Memphis003/OpenTrickler/CommunityContributions/Memphis/V1/readme.md

# A&D FX Shield by Memphis

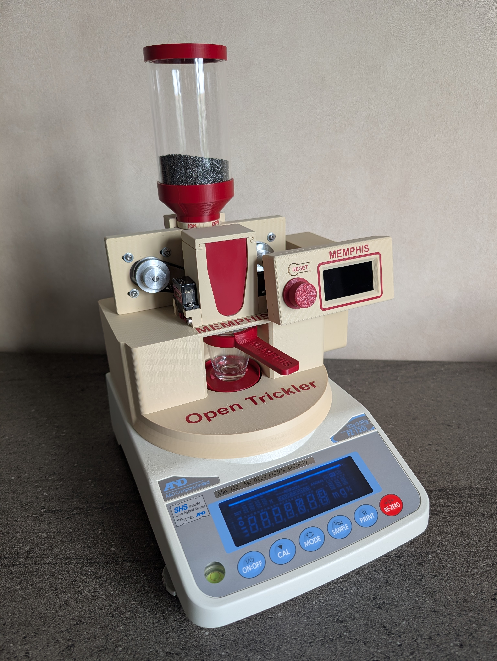
[picture p10: CommunityContributions/Memphis/V1/resources/Overview_1.jpg]

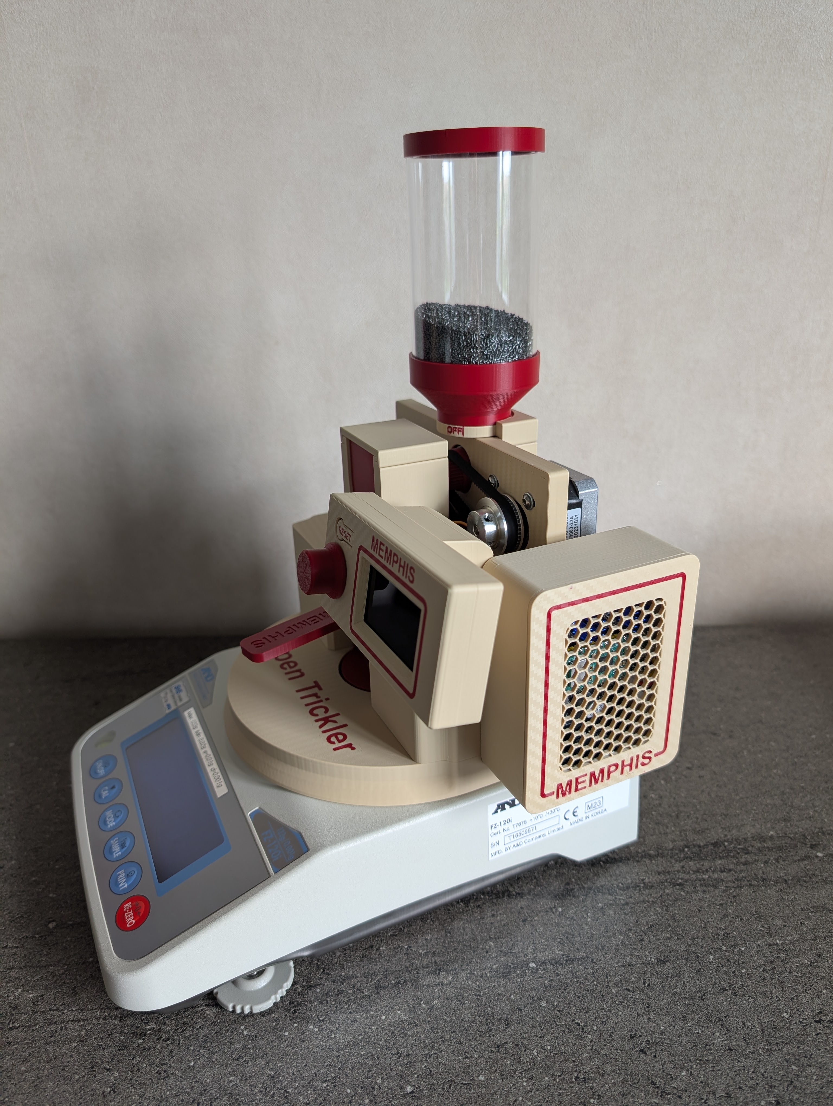
[picture p11: CommunityContributions/Memphis/V1/resources/Overview_2.jpg]

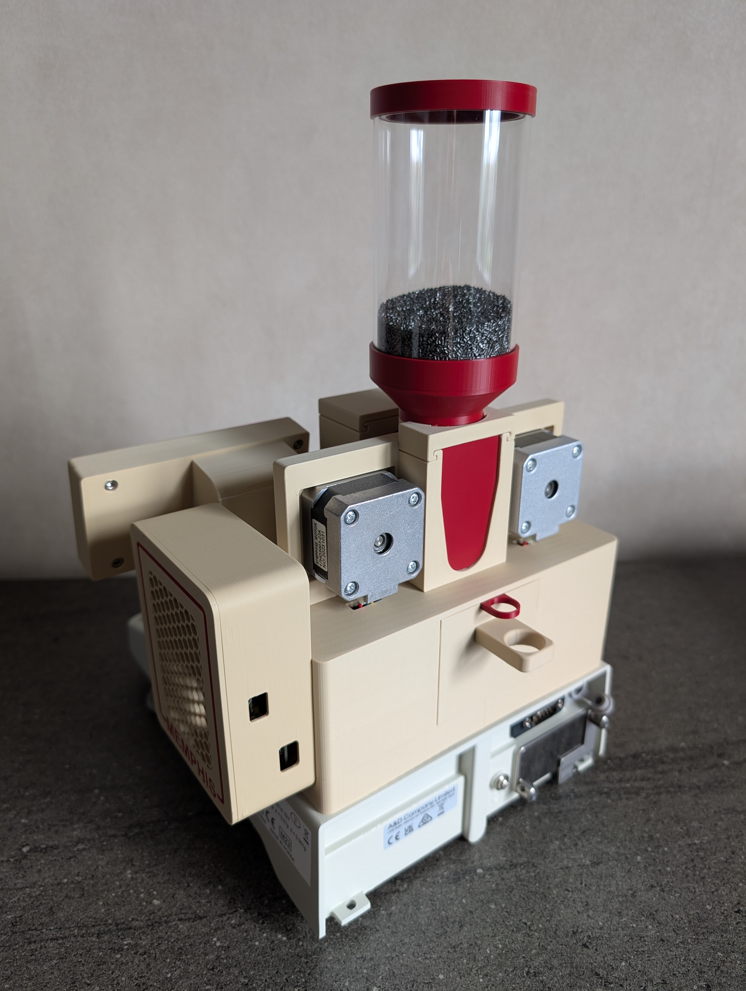
[picture p12: CommunityContributions/Memphis/V1/resources/Overview_3.jpg]

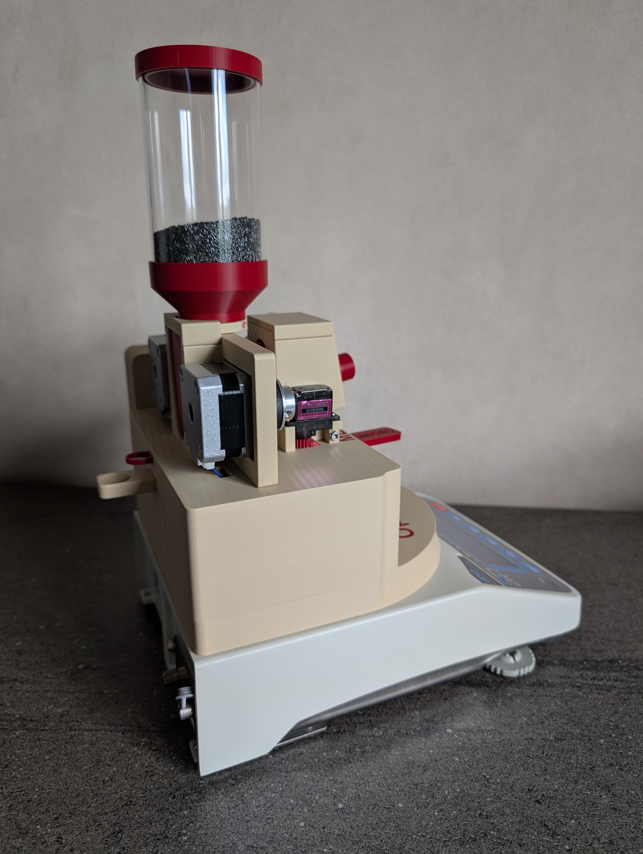
[picture p13: CommunityContributions/Memphis/V1/resources/Overview_4.jpg]
  

## BOM

- Heatset Inserts M3x5x4: 24
- Nut M3: 4
- M3x6 BHCS: 4
- M3x10 BHCS: 16
- M3x10 SHCS: 4 
- M3x12 SHCS: 4  

- A shot glass, height: 50mm, diameter at top: 41.6mm
- An o-ring 35mm in diameter  

- WS2812B led with cable and connector
- 13mm lens

## Assembly guide

### Rear discharge mount
Use 4x M3x12 SHCS with [rear_discharge_mount.stl](STL/rear_discharge_mount.stl) to join the [rear_body_without_holes.stl](STL/rear_body_without_holes.stl) to the [scale_shield.stl](STL/scale_shield.stl).
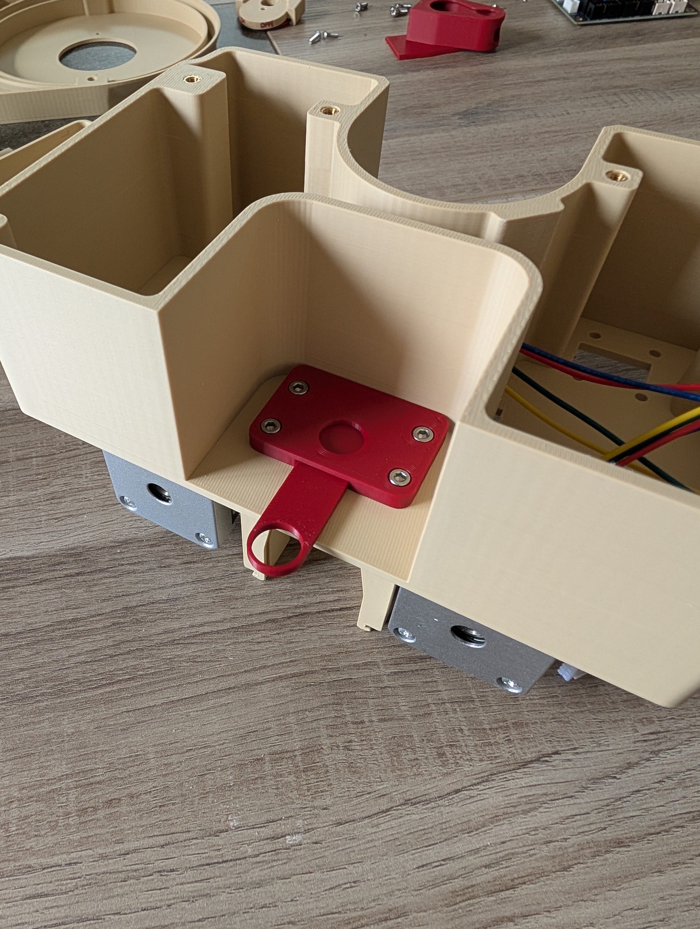
[picture p14: CommunityContributions/Memphis/V1/resources/Rear_discharge_mount.jpg]
  

### LED
Use one of the connectors provided with the 3D mellow PCB.  
Be sure to use the LED's DI pin.  
You need a 13mm diameter lens.  
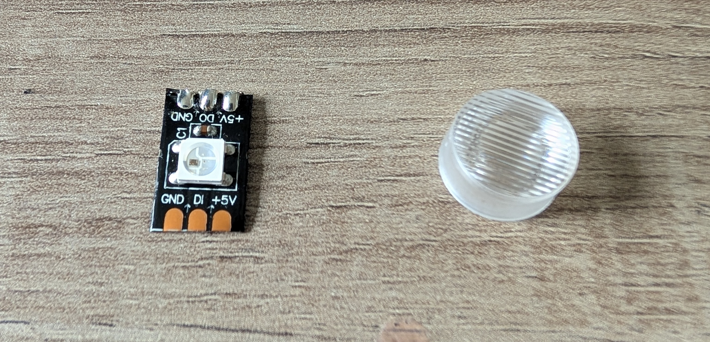
[picture p15: CommunityContributions/Memphis/V1/resources/Led_1.jpg]

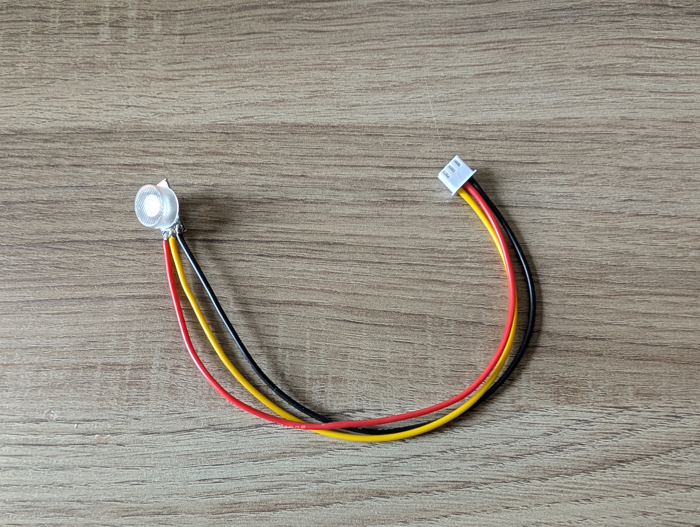
[picture p16: CommunityContributions/Memphis/V1/resources/Led_2.jpg]
  

Place the lens in the hole after adjusting it if necessary with a file and sandpaper.
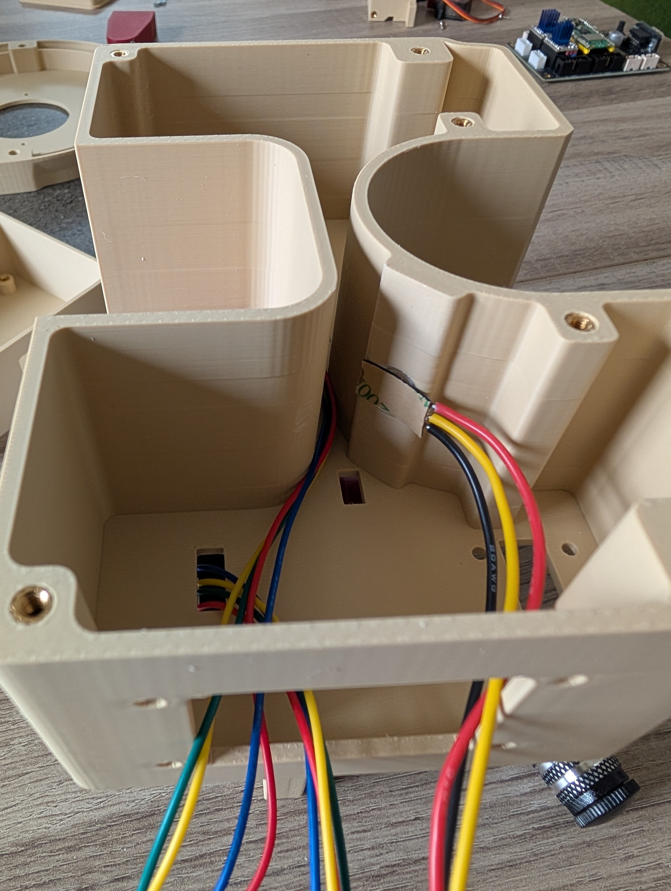
[picture p17: CommunityContributions/Memphis/V1/resources/Led_3.jpg]

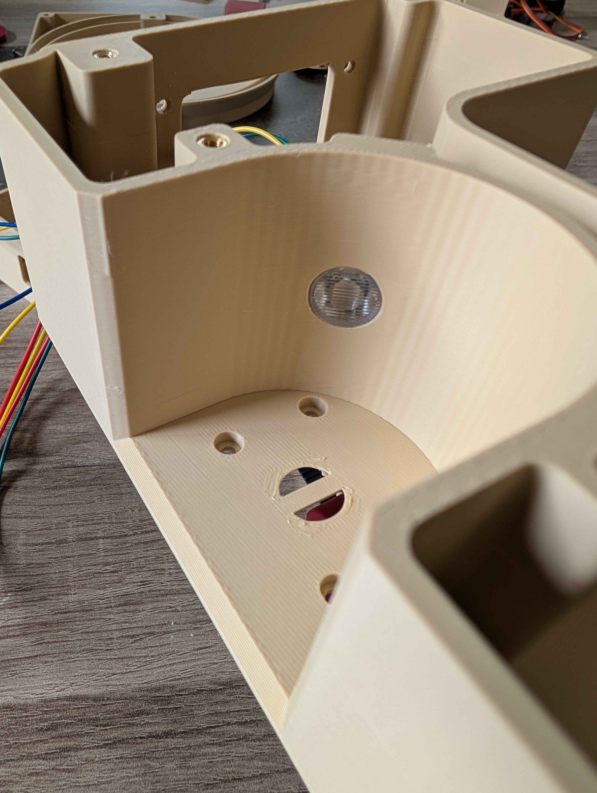
[picture p18: CommunityContributions/Memphis/V1/resources/Led_4.jpg]
  

### Display
Melt 8x heatset into the [display_assy_bracket.stl](STL/display_assy_bracket.stl).  
Use 4x M3x10 BHCS to join the [display_assy_body.stl](STL/display_assy_body.stl) to the [display_assy_bracket.stl](STL/display_assy_bracket.stl).
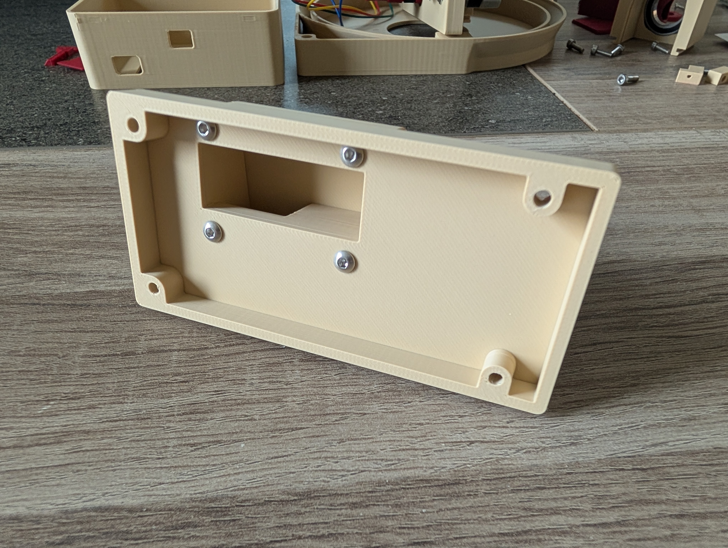
[picture p19: CommunityContributions/Memphis/V1/resources/Display_1.jpg]


Route the connection cables as shown in the photo.
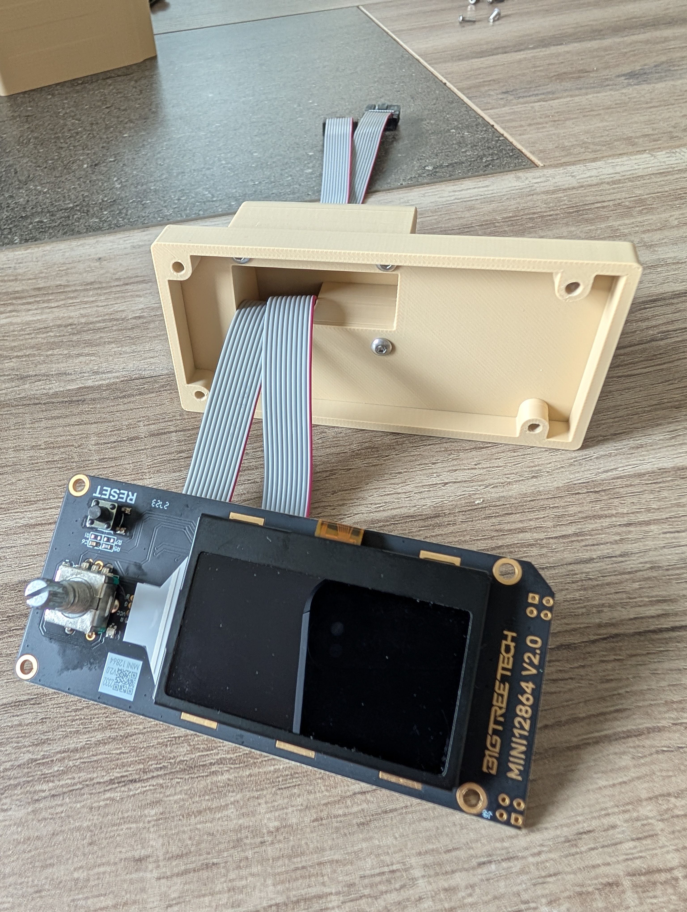
[picture p20: CommunityContributions/Memphis/V1/resources/Display_2.jpg]


Melt 4x heatset into [the display_assy_front.stl](STL/display_assy_front.stl).  
Use 4x M3x12 SHCS to join [display_assy_body.stl](STL/display_assy_body.stl) to the [the display_assy_front.stl](STL/display_assy_front.stl).
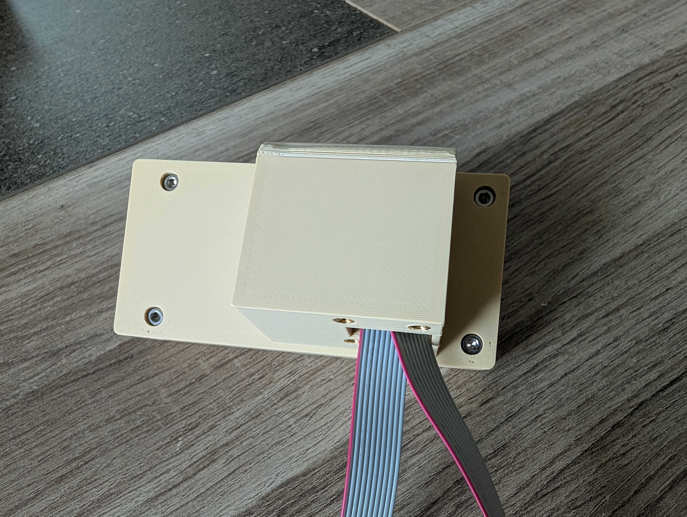
[picture p21: CommunityContributions/Memphis/V1/resources/Display_3.jpg]


Use 4x M3x10 BHCS to join the [display_assy_bracket.stl](STL/display_assy_bracket.stl) to the [scale_shield.stl](STL/scale_shield.stl).
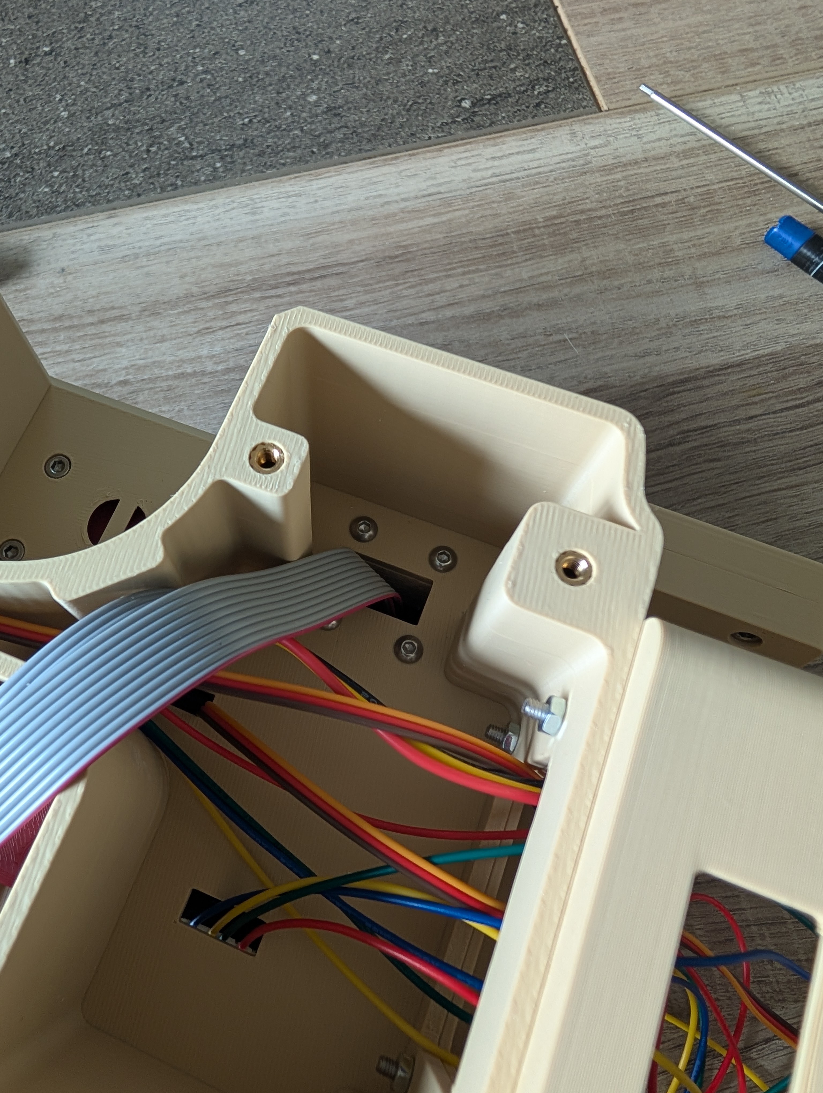
[picture p22: CommunityContributions/Memphis/V1/resources/Display_4.jpg]
  

### Enclosure
Melt 4x heatset into the [enclosure_bottom.stl](STL/enclosure_bottom.stl) to be able to fix the PCB.  
Use 4x M3x10 BHCS and 4x M3 nuts to join [enclosure_bottom.stl](STL/enclosure_bottom.stl) to [scale_shield.stl](STL/scale_shield.stl).  
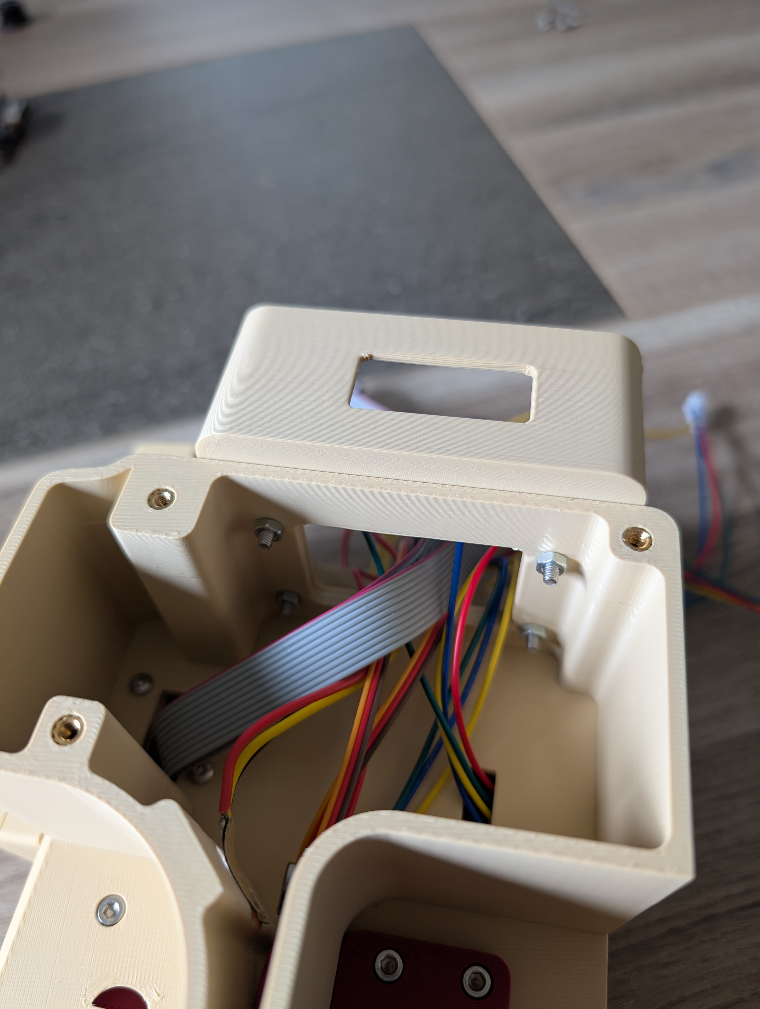
[picture p23: CommunityContributions/Memphis/V1/resources/Enclosure_1.jpg]
  

After passing all the cables, fix the PCB with 4x M3x6 BHCS screws.
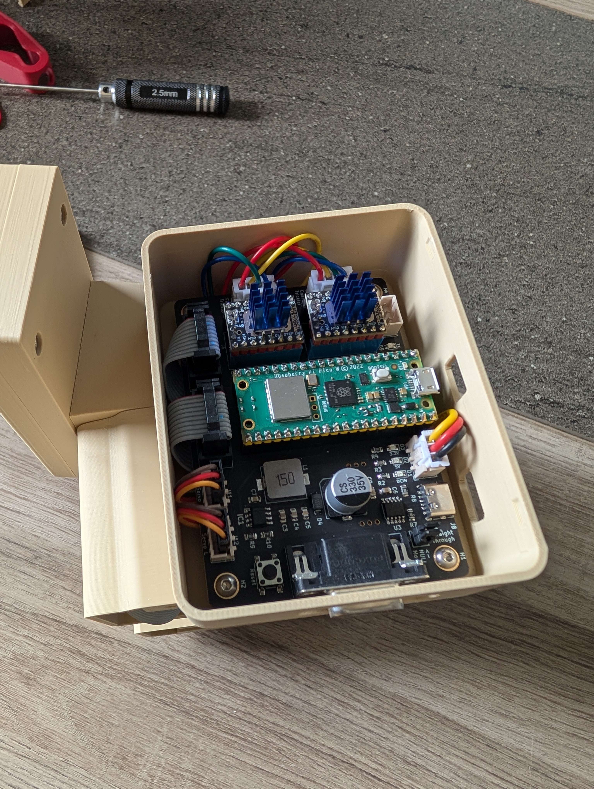
[picture p24: CommunityContributions/Memphis/V1/resources/Enclosure_2.jpg]
  

The case cover ([enclosure_top.stl](STL/enclosure_top.stl)) is simply snapped on.

### Scale base
Overview with all cables:
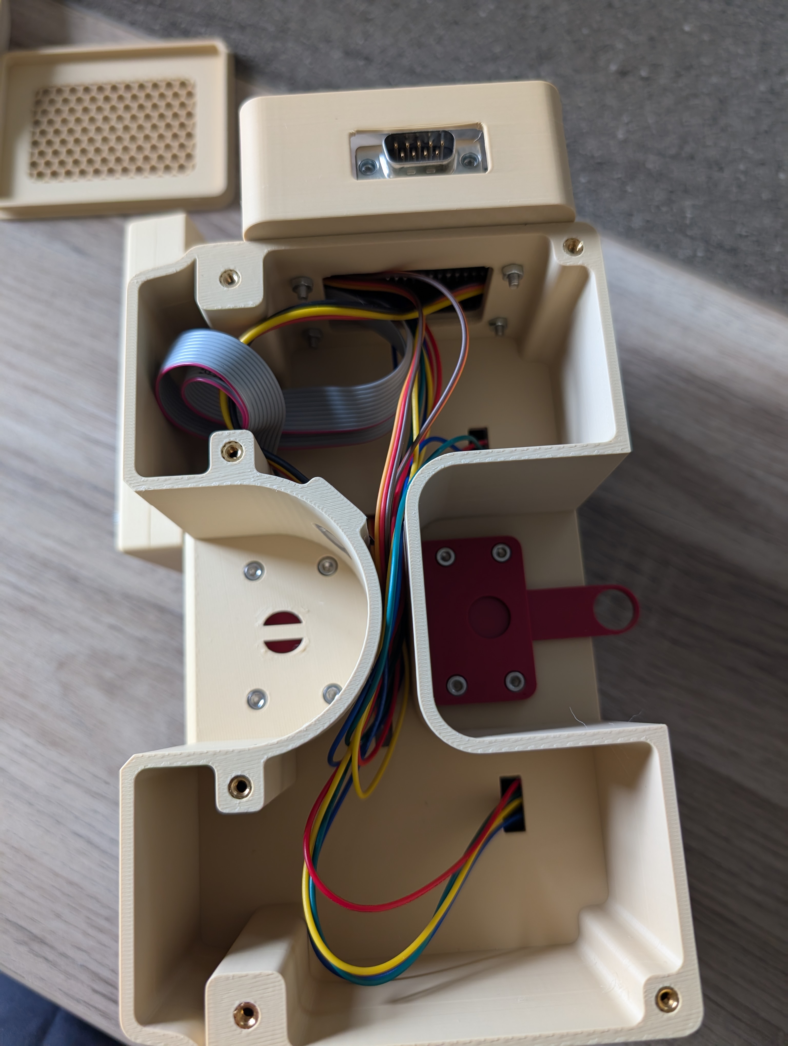
[picture p25: CommunityContributions/Memphis/V1/resources/Cable.jpg]
    
Use 4x M3x10 SHCS and 2x M3x10 BHCS to join the [scale_base.stl](STL/scale_base.stl) to the [scale_shield.stl](STL/scale_shield.stl).
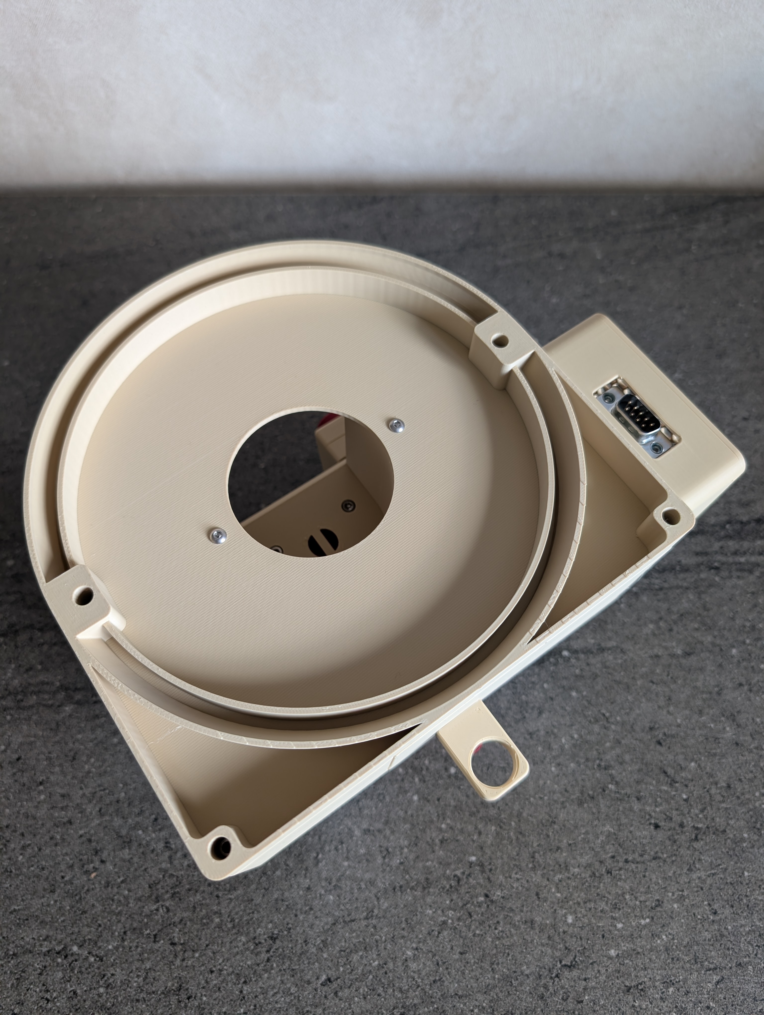
[picture p26: CommunityContributions/Memphis/V1/resources/Scale_base.jpg]
  

## Cup base 
Use the first weighing plate and add a piece of tape to fix the [cup_base.stl](STL/cup_base.stl).
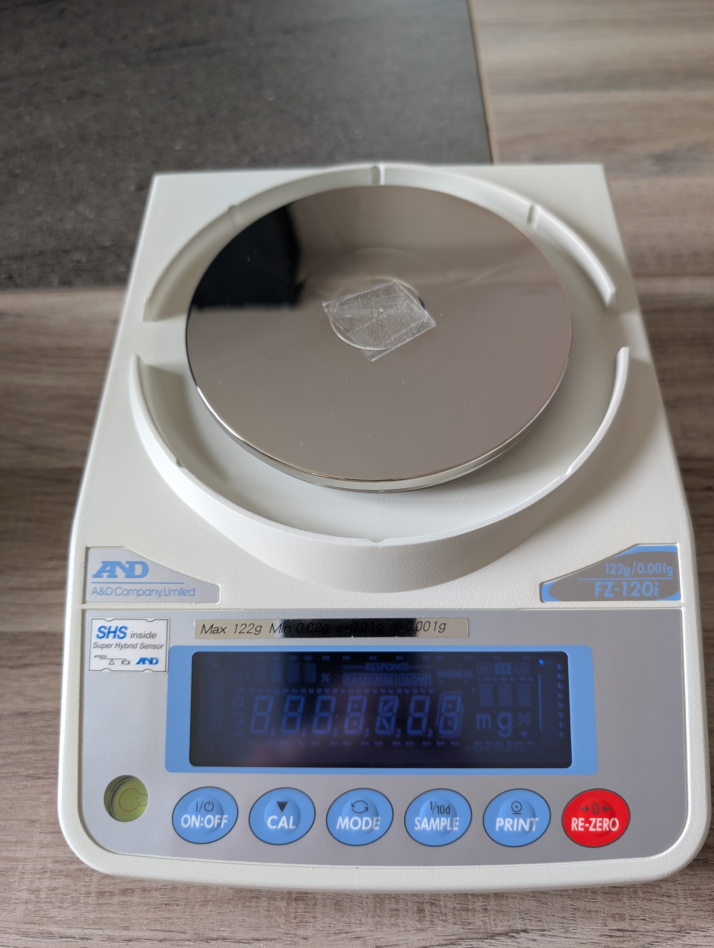
[picture p27: CommunityContributions/Memphis/V1/resources/Cup_base.jpg]
  

## Rear discharger cup
[rear_discharger_cup.stl](STL/rear_discharger_cup.stl)  
[rear_discharge_cup_ring.stl](STL/rear_discharge_cup_ring.stl)  
2x heatset  
2x M3x10 SHCS
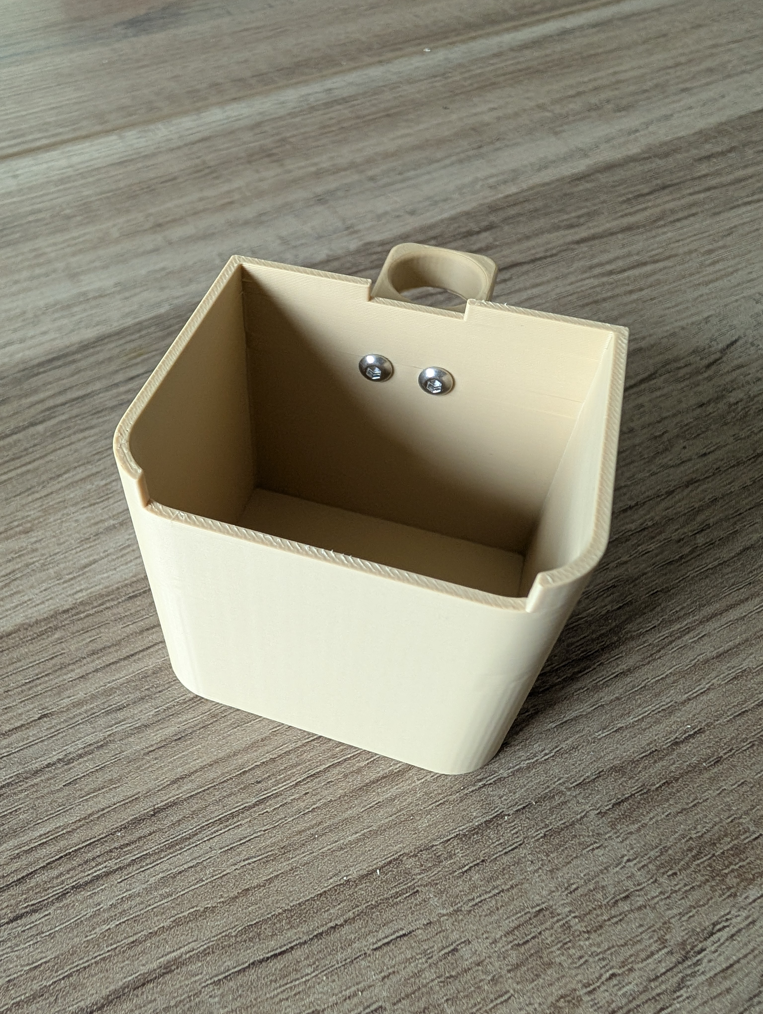
[picture p28: CommunityContributions/Memphis/V1/resources/Rear_discharger_cup.jpg]
  

## Powder cup
It is possible not to use the o-ring if your print is very tight.  
[powder_cup_handle.stl](STL/powder_cup_handle.stl)
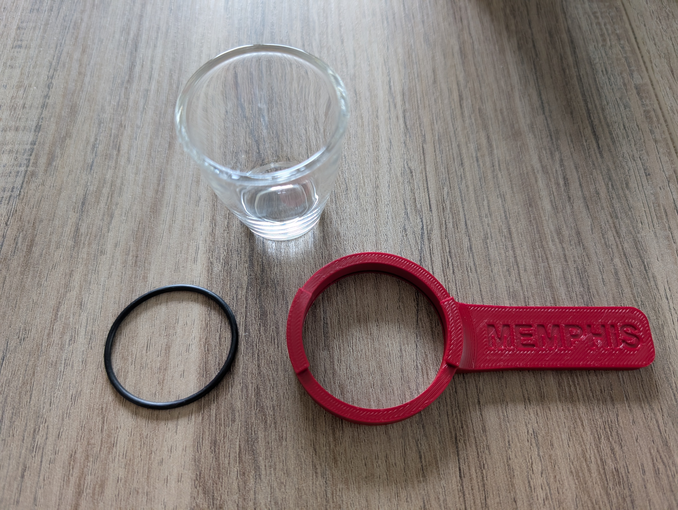
[picture p29: CommunityContributions/Memphis/V1/resources/Powder_cup_1.jpg]

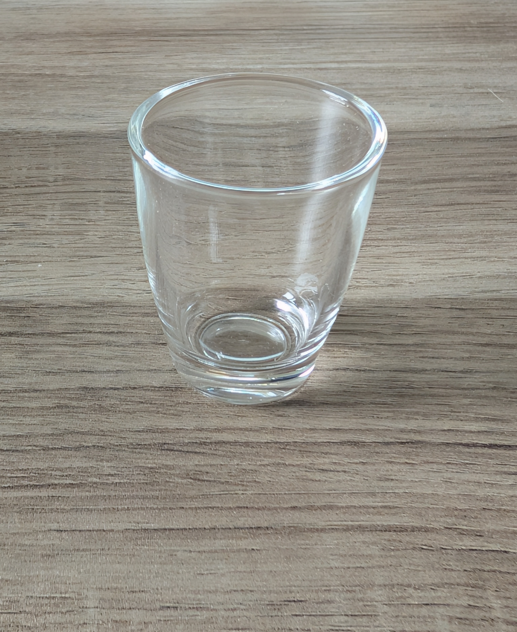
[picture p30: CommunityContributions/Memphis/V1/resources/Powder_cup_2.jpg]

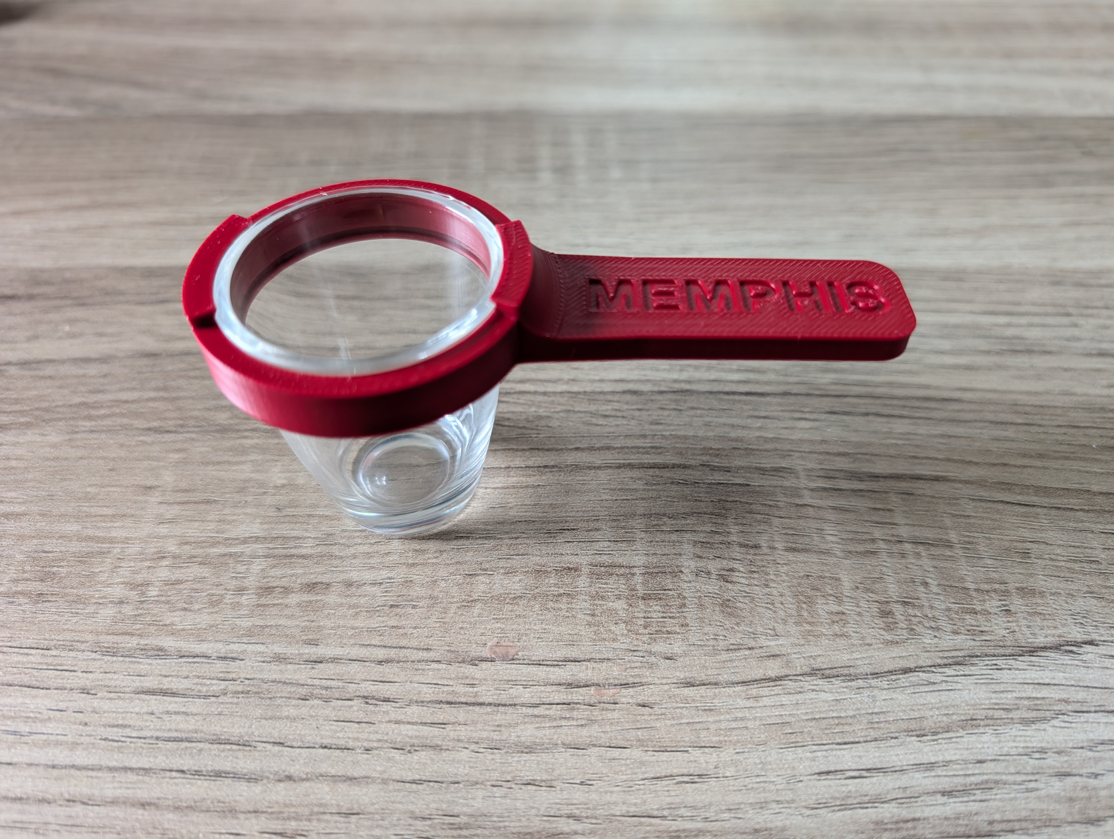
[picture p31: CommunityContributions/Memphis/V1/resources/Powder_cup_3.jpg]
  

## Options:
### Powder hopper:
Clear acrylic tube, outer diameter: 60mm and inner diameter: 56mm  
[hopper_base_plexi.stl](STL/hopper_base_plexi.stl)  
[hopper_cap.stl](STL/hopper_cap.stl)
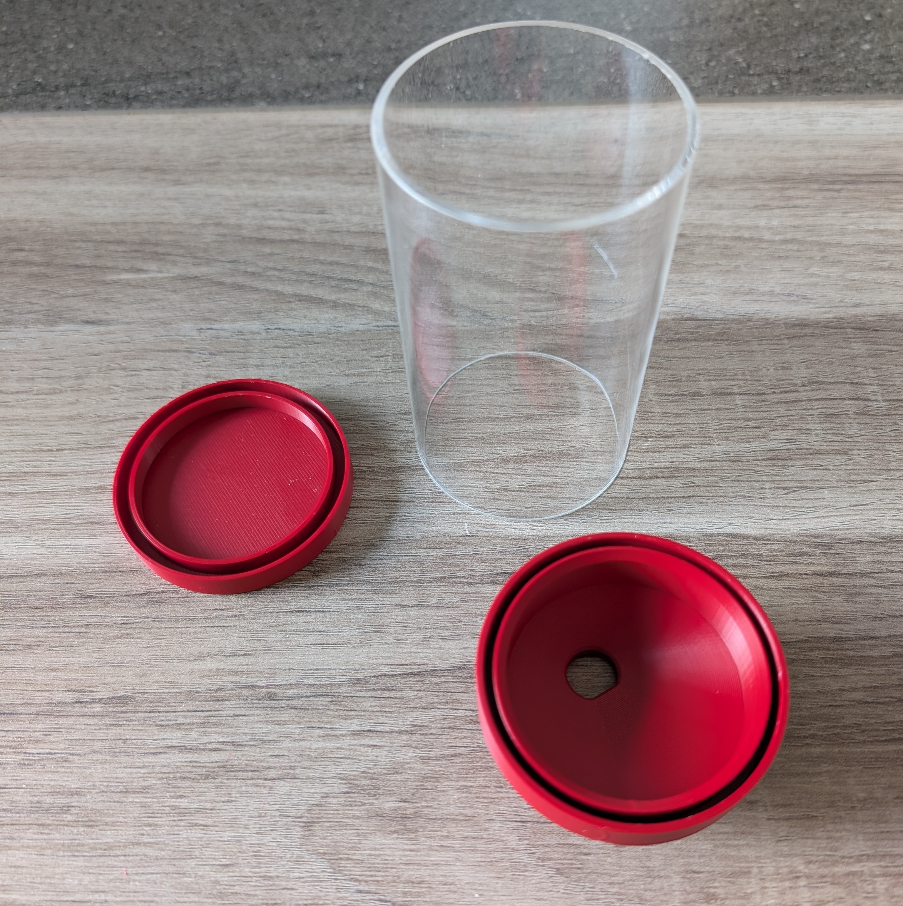
[picture p32: CommunityContributions/Memphis/V1/resources/Hopper.jpg]
  

### Rear body:
Rear body without holes on the sides ([rear_body_without_holes.stl](STL/rear_body_without_holes.stl))
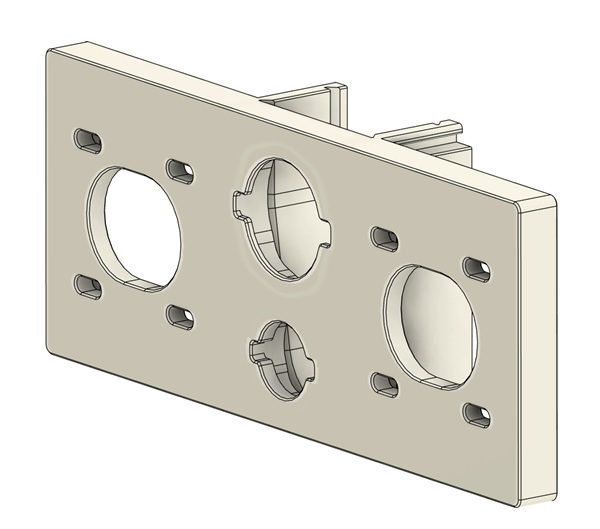
[picture p33: CommunityContributions/Memphis/V1/resources/Rear_body_memphis.jpg]
