Memphis003/OpenTrickler/CommunityContributions/Memphis/V2/3MF/Hopper/HopperBasePlexi.3mf

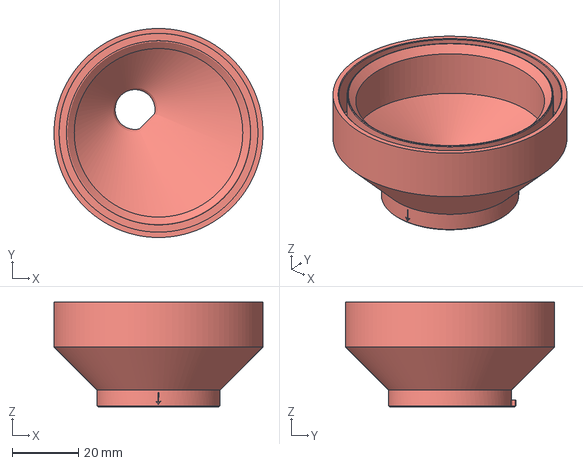
[picture p36: CAD file, 2026-04-20]
CommunityContributions/Memphis/V2/3MF/Hopper/HopperBasePlexi.3mf
63.0 x 63.0 x 31.5 mm
