Memphis003/OpenTrickler/CommunityContributions/Memphis/V2/3MF/Interface/InterfaceFrontFlap.3mf

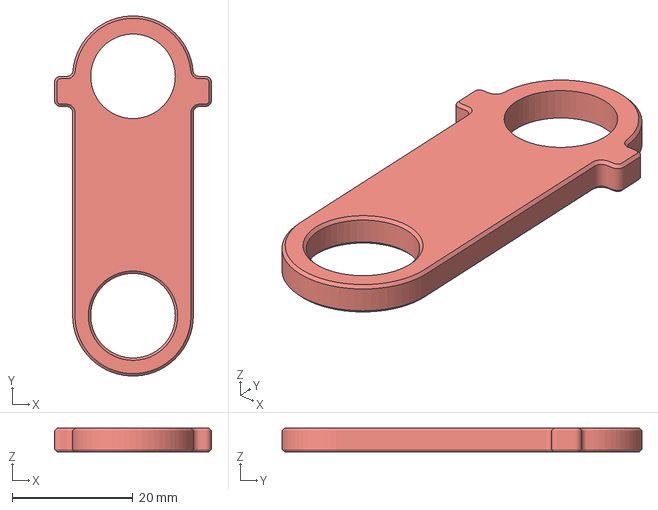
[picture p37: CAD file, 2026-04-20]
CommunityContributions/Memphis/V2/3MF/Interface/InterfaceFrontFlap.3mf
26.0 x 59.6 x 3.90 mm
