Memphis003/OpenTrickler/CommunityContributions/Memphis/V2/3MF/Lid/SmallCableLock.3mf

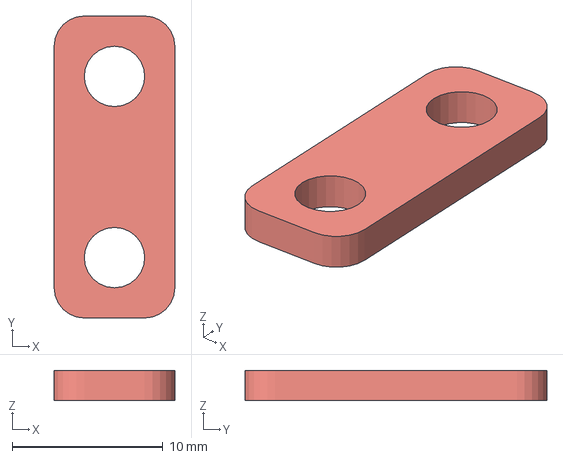
[picture p38: CAD file, 2026-04-20]
CommunityContributions/Memphis/V2/3MF/Lid/SmallCableLock.3mf
8.00 x 20.0 x 2.00 mm
