Memphis003/OpenTrickler/CommunityContributions/Memphis/V2/3MF/OpenTricklerOrignalParts/RearDoor.3mf

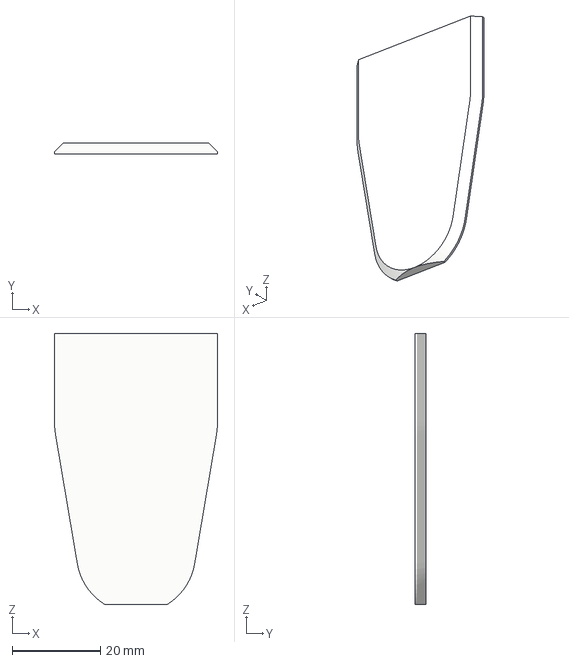
[picture p39: CAD file, 2026-04-20]
CommunityContributions/Memphis/V2/3MF/OpenTricklerOrignalParts/RearDoor.3mf
37.0 x 2.50 x 61.5 mm
