Memphis003/OpenTrickler/CommunityContributions/Memphis/V2/3MF/PCB/Enclosure.3mf

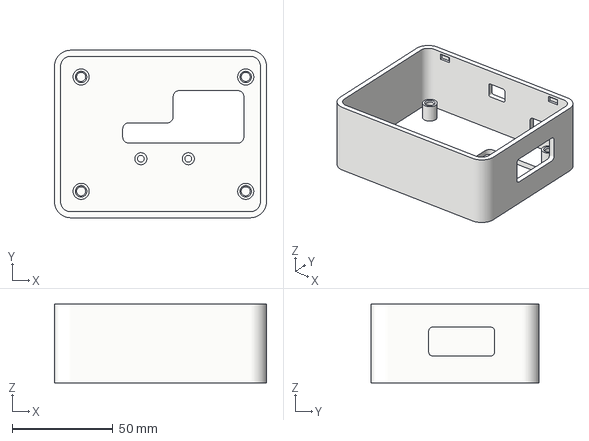
[picture p40: CAD file, 2026-04-20]
CommunityContributions/Memphis/V2/3MF/PCB/Enclosure.3mf
105.0 x 83.0 x 39.0 mm
