Memphis003/OpenTrickler/CommunityContributions/Memphis/V2/3MF/RearBodyWithoutHolesOnTheLeft.3mf

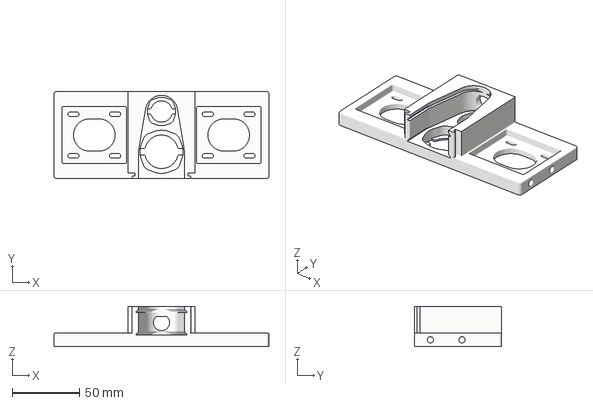
[picture p41: CAD file, 2026-04-20]
CommunityContributions/Memphis/V2/3MF/RearBodyWithoutHolesOnTheLeft.3mf
160.0 x 65.0 x 30.0 mm
