Memphis003/OpenTrickler/CommunityContributions/Memphis/V2/3MF/Display/BigTreetechScreen_Front.3mf

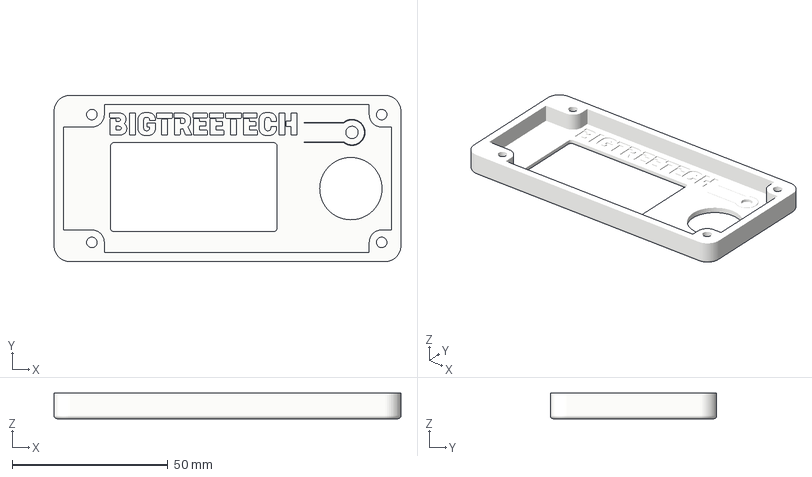
[picture p42: CAD file, 2026-04-20]
CommunityContributions/Memphis/V2/3MF/Display/BigTreetechScreen_Front.3mf
111.4 x 53.4 x 8.20 mm
Front
Text (1)
Text (10)
Text (11)
Text (12)
Text (13)
Text (14)
Text (15)
Text (16)
Text (17)
Text (18)
Text (19)
Text (2)
Text (3)
Text (4)
Text (5)
Text (6)
Text (7)
Text (8)
Text (9)
Text
