Memphis003/OpenTrickler/CommunityContributions/Memphis/V2/3MF/FrontBody/FrontVolumeReducerWithHole.3mf

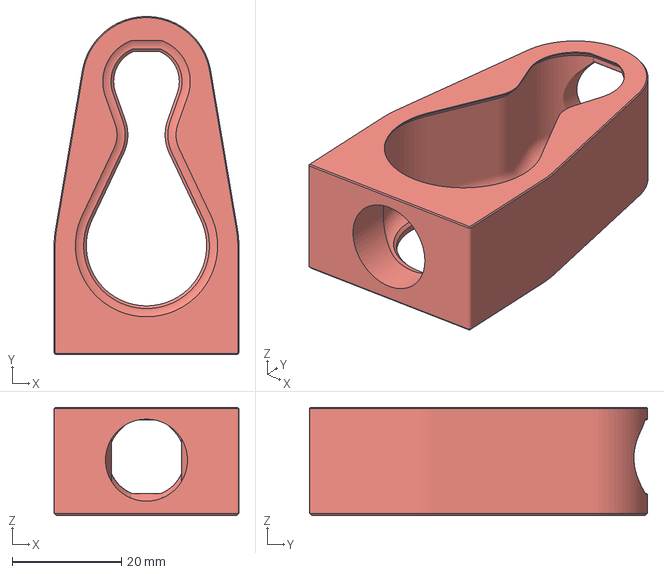
[picture p43: CAD file, 2026-04-20]
CommunityContributions/Memphis/V2/3MF/FrontBody/FrontVolumeReducerWithHole.3mf
33.8 x 61.8 x 19.8 mm
