Memphis003/OpenTrickler/CommunityContributions/Memphis/V2/3MF/Hopper/HopperCap.3mf

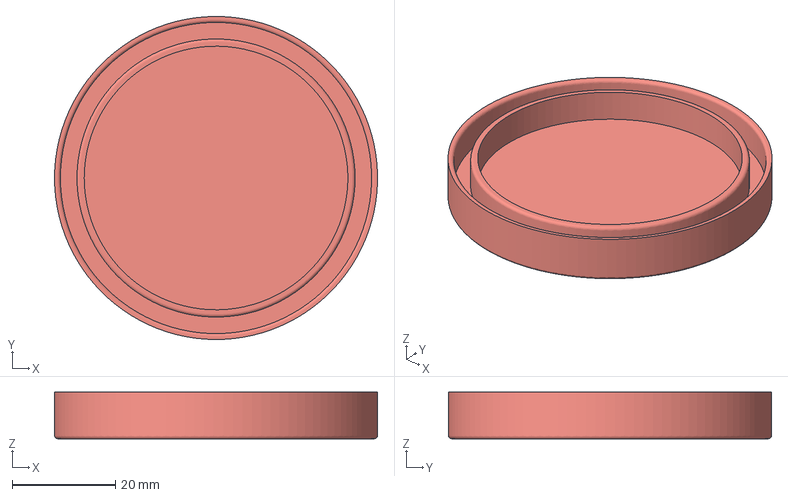
[picture p44: CAD file, 2026-03-31]
CommunityContributions/Memphis/V2/3MF/Hopper/HopperCap.3mf
62.5 x 62.5 x 9.00 mm
