Memphis003/OpenTrickler/CommunityContributions/Memphis/V2/3MF/Interface/InterfaceWithServos.3mf

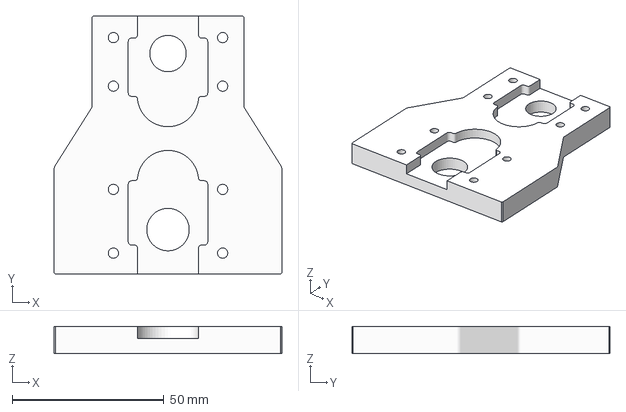
[picture p45: CAD file, 2026-04-20]
CommunityContributions/Memphis/V2/3MF/Interface/InterfaceWithServos.3mf
75.0 x 85.0 x 9.00 mm
