Memphis003/OpenTrickler/CommunityContributions/Memphis/V2/3MF/Lid/Lid_Servos.3mf

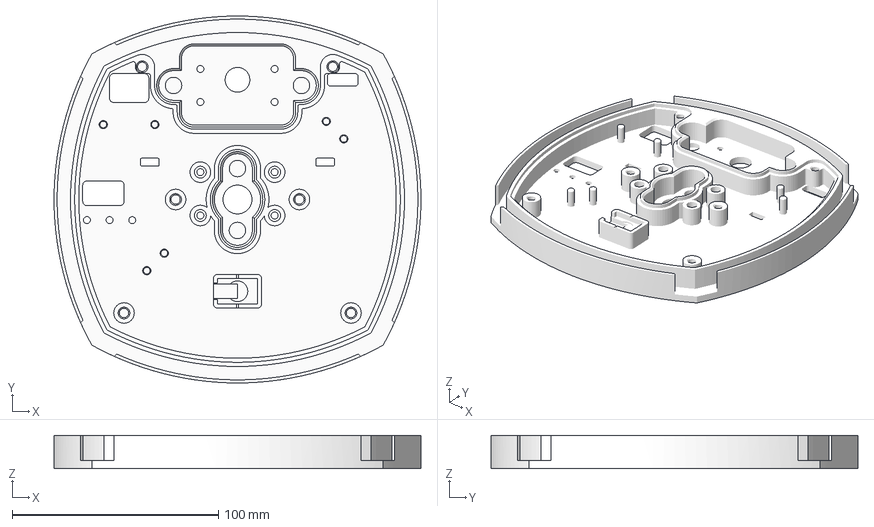
[picture p46: CAD file, 2026-04-20]
CommunityContributions/Memphis/V2/3MF/Lid/Lid_Servos.3mf
177.8 x 177.8 x 16.0 mm
Lid (1)
MemphisText (1)
MemphisText (2)
MemphisText (3)
MemphisText (4)
MemphisText (5)
MemphisText (6)
MemphisText
OpenTricklerText (1)
OpenTricklerText (10)
OpenTricklerText (11)
OpenTricklerText (12)
OpenTricklerText (13)
OpenTricklerText (14)
OpenTricklerText (2)
OpenTricklerText (3)
OpenTricklerText (4)
OpenTricklerText (5)
OpenTricklerText (6)
OpenTricklerText (7)
OpenTricklerText (8)
OpenTricklerText (9)
OpenTricklerText
