Memphis003/OpenTrickler/CommunityContributions/Memphis/V2/3MF/Lid_LEDStrip_AddOn.3mf

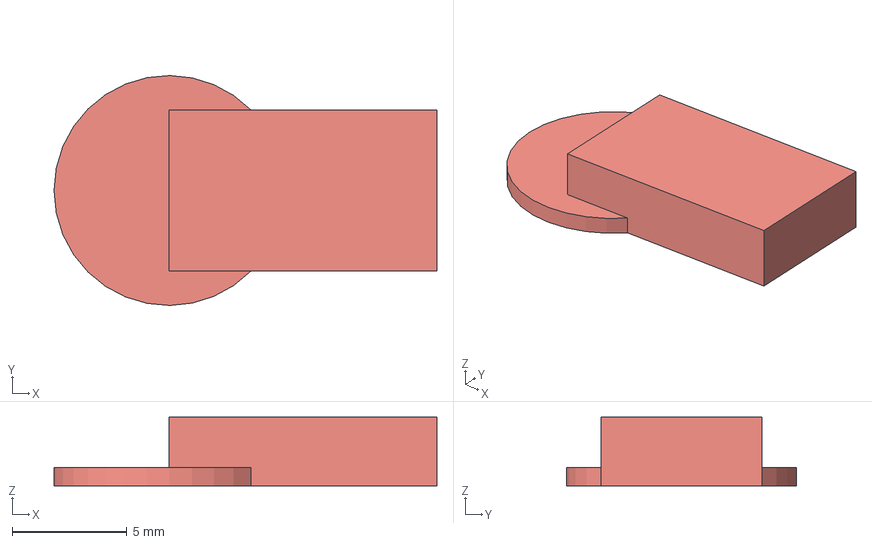
[picture p47: CAD file, 2026-04-20]
CommunityContributions/Memphis/V2/3MF/Lid_LEDStrip_AddOn.3mf
16.7 x 10.00 x 3.00 mm
