Memphis003/OpenTrickler/CommunityContributions/Memphis/V2/3MF/OpenTricklerOrignalParts/RearVolumeReducer.3mf

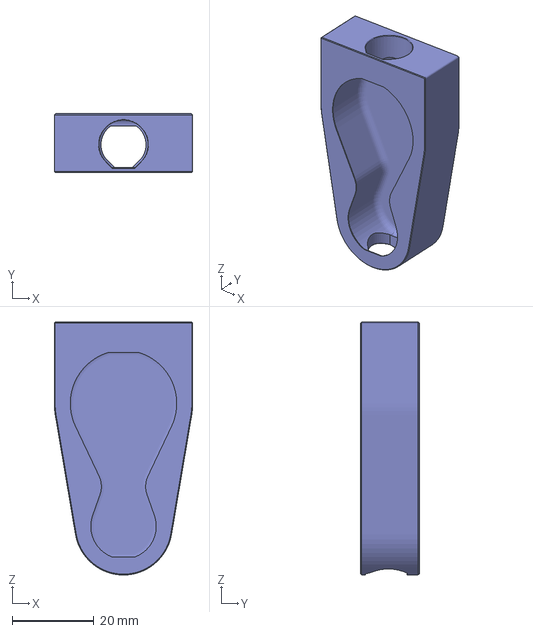
[picture p48: CAD file, 2026-04-20]
CommunityContributions/Memphis/V2/3MF/OpenTricklerOrignalParts/RearVolumeReducer.3mf
33.8 x 14.3 x 61.8 mm
