Memphis003/OpenTrickler/CommunityContributions/Memphis/V2/3MF/PCB/Enclosure_Lid.3mf

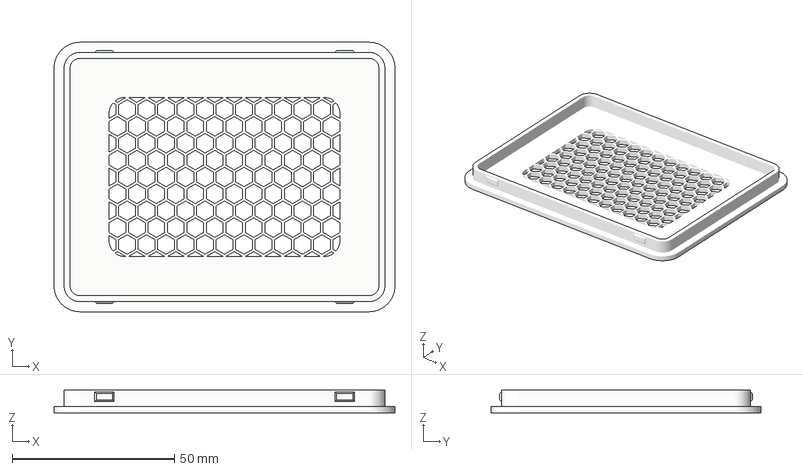
[picture p49: CAD file, 2026-04-20]
CommunityContributions/Memphis/V2/3MF/PCB/Enclosure_Lid.3mf
105.0 x 83.0 x 7.00 mm
Edging
Lid
MemphisText (1)
MemphisText (2)
MemphisText (3)
MemphisText (4)
MemphisText (5)
MemphisText (6)
MemphisText
