Memphis003/OpenTrickler/CommunityContributions/Memphis/V2/3MF/FrontBody/FrontCover.3mf

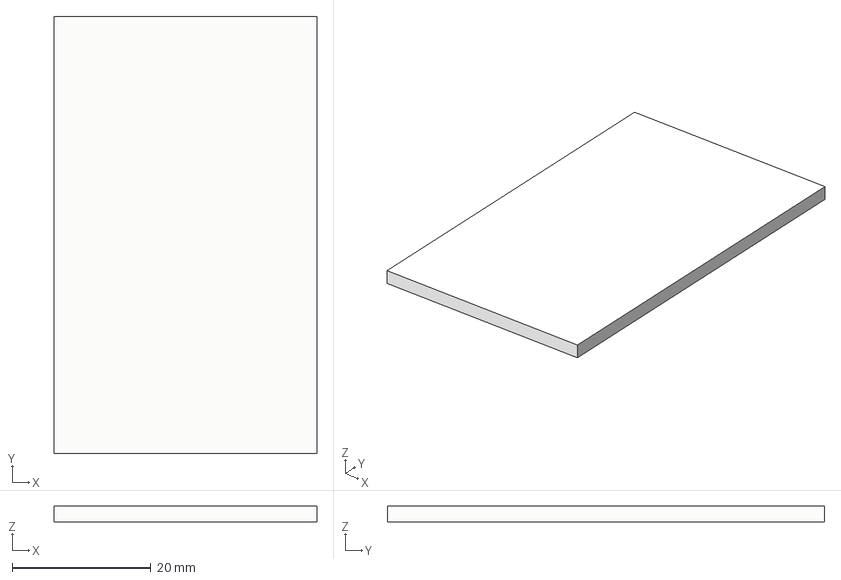
[picture p50: CAD file, 2026-04-20]
CommunityContributions/Memphis/V2/3MF/FrontBody/FrontCover.3mf
37.8 x 62.9 x 2.30 mm
