Memphis003/OpenTrickler/CommunityContributions/Memphis/V2/3MF/Interface/Interface.3mf

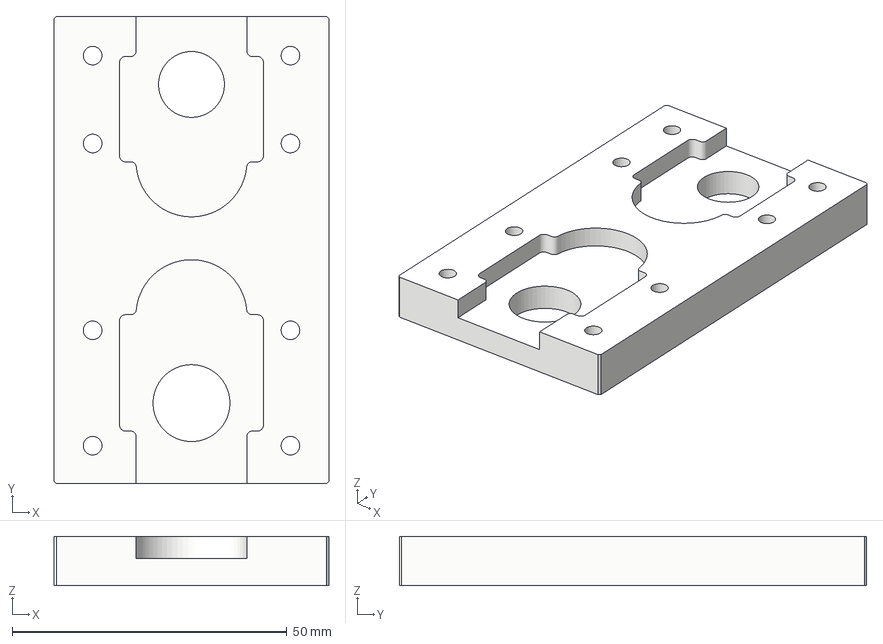
[picture p51: CAD file, 2026-04-20]
CommunityContributions/Memphis/V2/3MF/Interface/Interface.3mf
50.0 x 85.0 x 9.00 mm
