Memphis003/OpenTrickler/CommunityContributions/Memphis/V2/3MF/Lid/Lid_WireCover.3mf

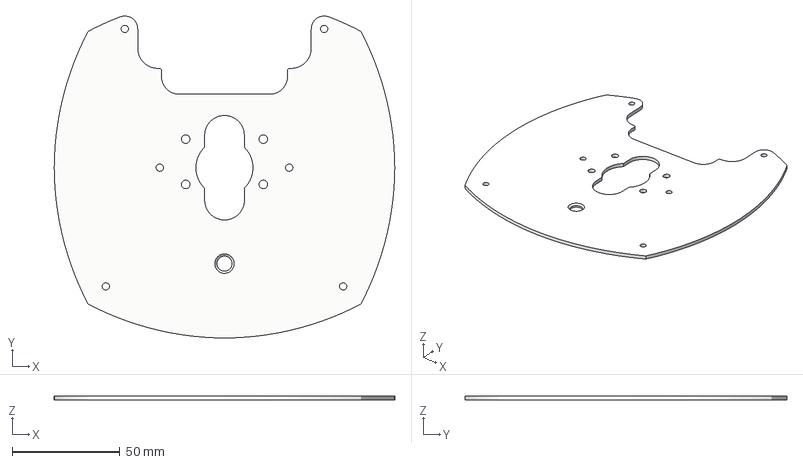
[picture p52: CAD file, 2026-04-20]
CommunityContributions/Memphis/V2/3MF/Lid/Lid_WireCover.3mf
157.8 x 149.2 x 2.00 mm
