Memphis003/OpenTrickler/CommunityContributions/Memphis/V2/3MF/OpenTricklerOrignalParts/FrontVolumeReducerBack.3mf

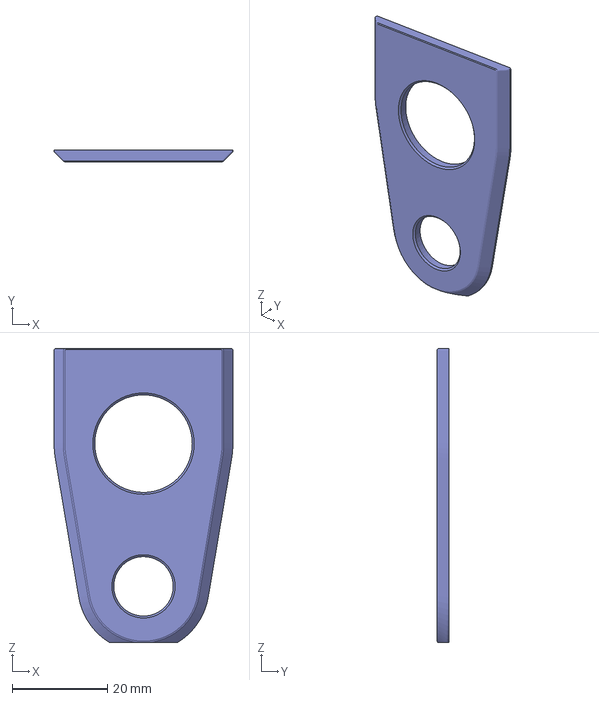
[picture p53: CAD file, 2026-04-20]
CommunityContributions/Memphis/V2/3MF/OpenTricklerOrignalParts/FrontVolumeReducerBack.3mf
37.6 x 2.50 x 61.8 mm
