Memphis003/OpenTrickler/CommunityContributions/Memphis/V2/3MF/RearBodyInterfaceModified.3mf

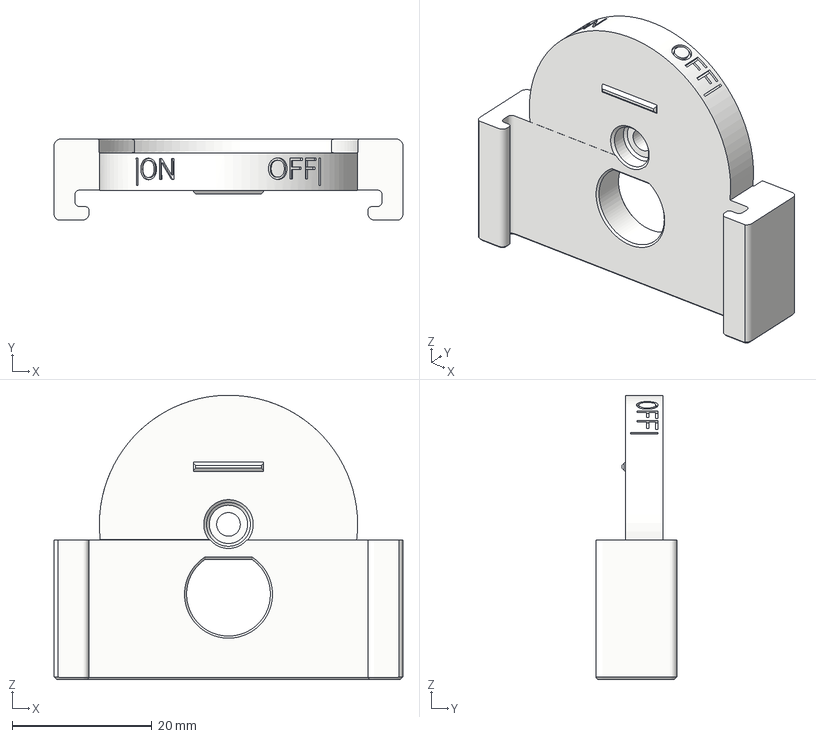
[picture p54: CAD file, 2026-04-20]
CommunityContributions/Memphis/V2/3MF/RearBodyInterfaceModified.3mf
50.0 x 11.6 x 40.7 mm
