Memphis003/OpenTrickler/CommunityContributions/Memphis/V2/3MF/Display/FlyScreen_Back.3mf

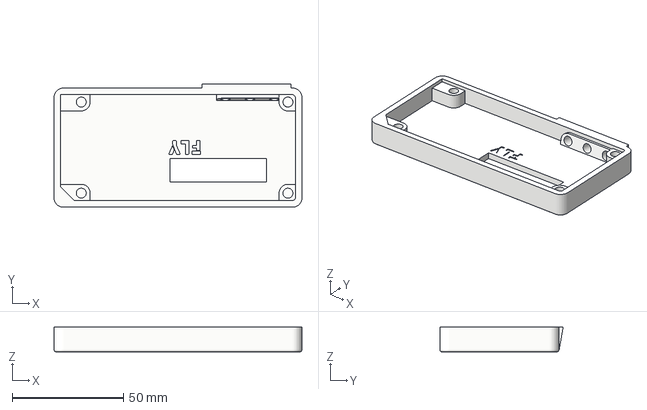
[picture p55: CAD file, 2026-04-20]
CommunityContributions/Memphis/V2/3MF/Display/FlyScreen_Back.3mf
111.6 x 55.5 x 11.2 mm
