Memphis003/OpenTrickler/CommunityContributions/Memphis/V2/3MF/FrontBody/Cap.3mf

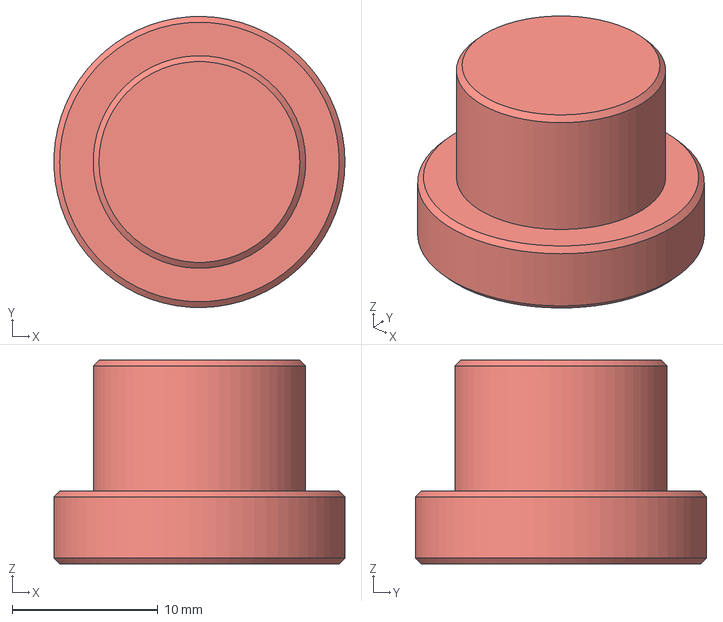
[picture p56: CAD file, 2026-04-20]
CommunityContributions/Memphis/V2/3MF/FrontBody/Cap.3mf
20.0 x 20.0 x 14.0 mm
