Memphis003/OpenTrickler/CommunityContributions/Memphis/V2/3MF/Interface/InterfaceRearFlap.3mf

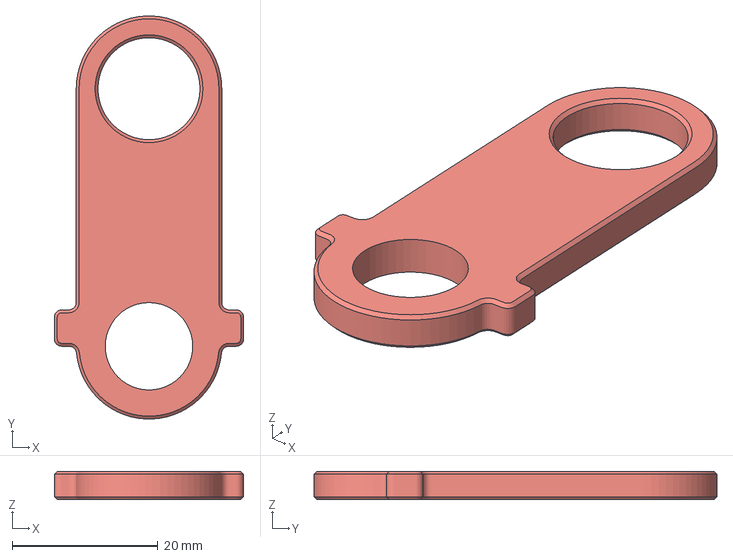
[picture p57: CAD file, 2026-04-20]
CommunityContributions/Memphis/V2/3MF/Interface/InterfaceRearFlap.3mf
26.0 x 55.3 x 3.90 mm
