Memphis003/OpenTrickler/CommunityContributions/Memphis/V2/3MF/PowderCuphandle.3mf

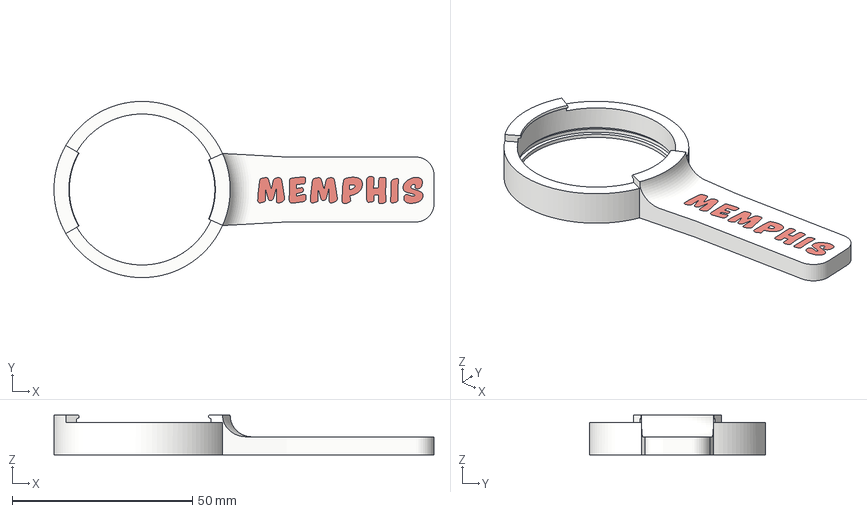
[picture p58: CAD file, 2026-04-20]
CommunityContributions/Memphis/V2/3MF/PowderCuphandle.3mf
105.3 x 48.8 x 11.0 mm
Handle
Texte (1)
Texte (2)
Texte (3)
Texte (4)
Texte (5)
Texte (6)
Texte
