Memphis003/OpenTrickler/CommunityContributions/Memphis/V2/3MF/CupStop.3mf

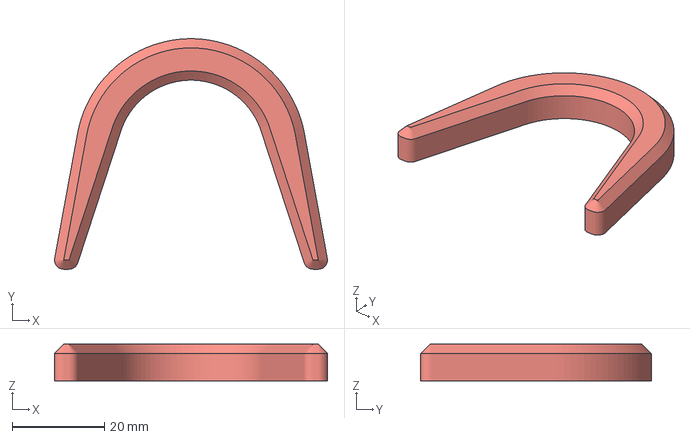
[picture p59: CAD file, 2026-03-31]
CommunityContributions/Memphis/V2/3MF/CupStop.3mf
59.2 x 50.0 x 8.00 mm
