Memphis003/OpenTrickler/CommunityContributions/Memphis/V2/3MF/Display/BigTreetechScreen_Back.3mf

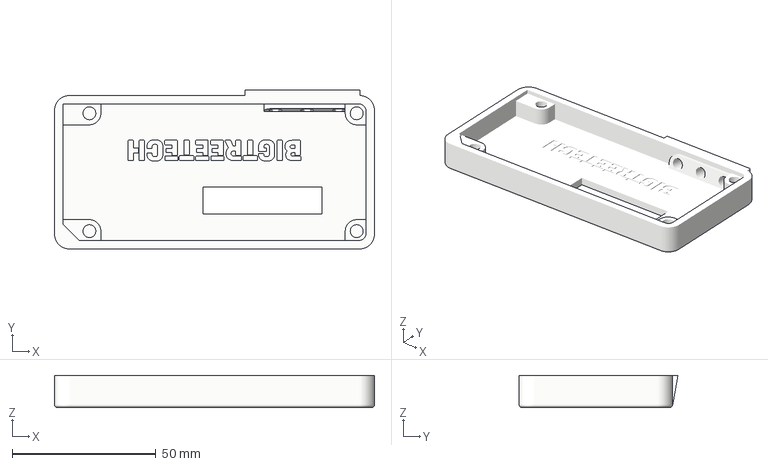
[picture p60: CAD file, 2026-04-20]
CommunityContributions/Memphis/V2/3MF/Display/BigTreetechScreen_Back.3mf
111.4 x 55.3 x 11.2 mm
