Memphis003/OpenTrickler/CommunityContributions/Memphis/V2/3MF/FrontBody/FrontBodyCoverWithHole.3mf

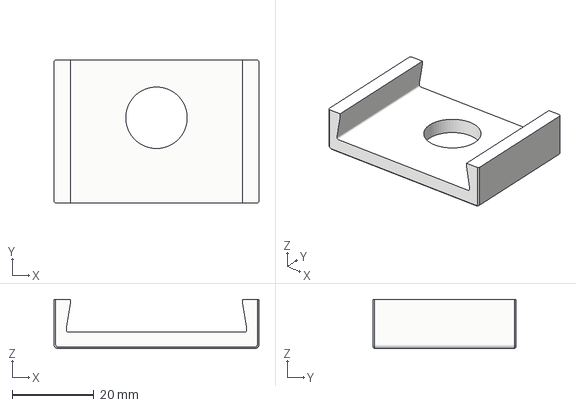
[picture p61: CAD file, 2026-04-20]
CommunityContributions/Memphis/V2/3MF/FrontBody/FrontBodyCoverWithHole.3mf
50.0 x 35.0 x 12.0 mm
