Memphis003/OpenTrickler/CommunityContributions/Memphis/V2/3MF/Lid/BigCableBlock.3mf

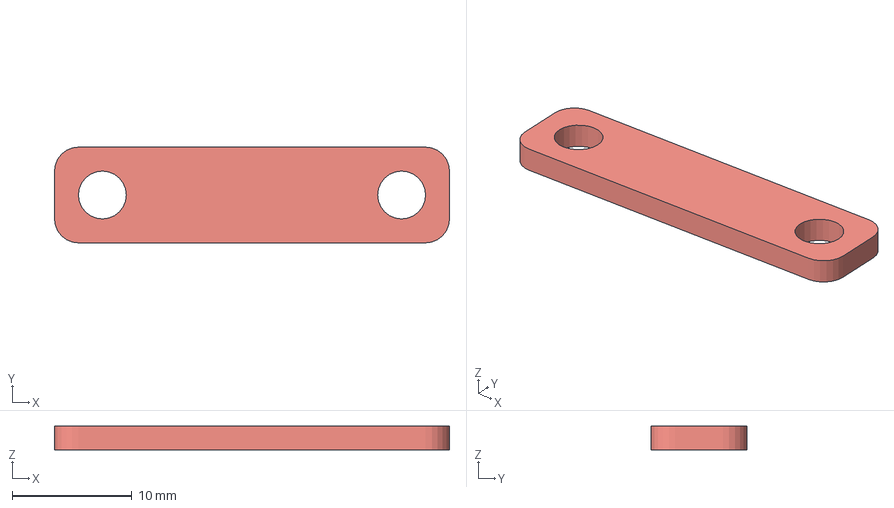
[picture p62: CAD file, 2026-04-20]
CommunityContributions/Memphis/V2/3MF/Lid/BigCableBlock.3mf
33.0 x 8.00 x 2.00 mm
