Memphis003/OpenTrickler/CommunityContributions/Memphis/V2/3MF/OpenTricklerOrignalParts/SmallRotaryTube_LowFlowTube.3mf

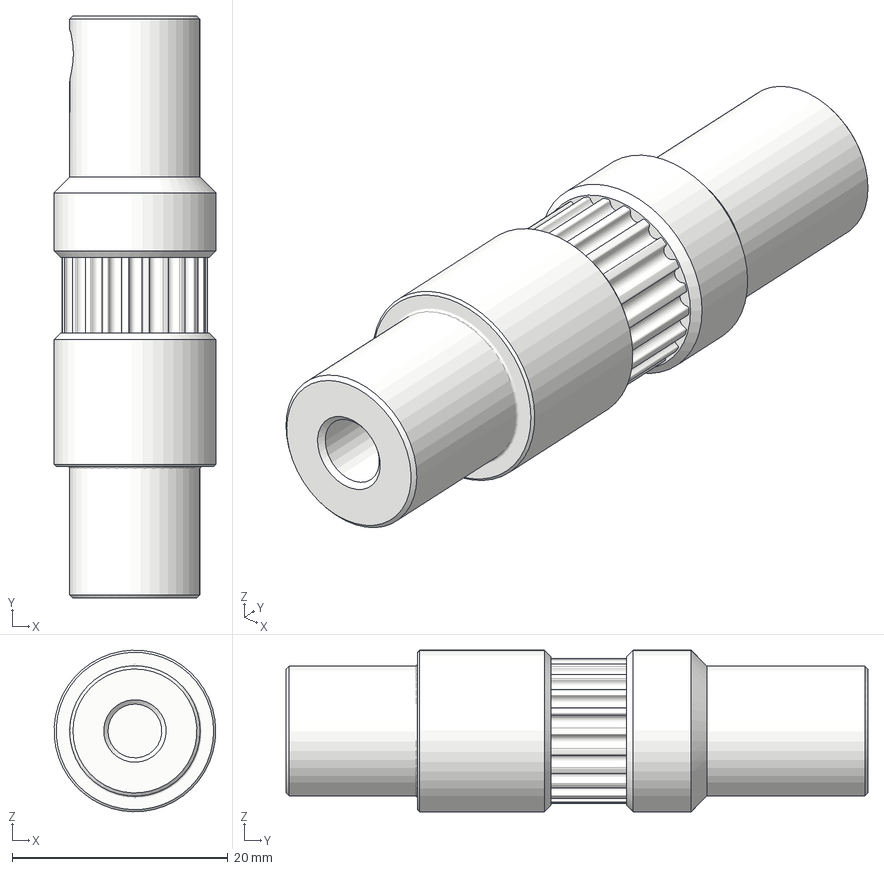
[picture p63: CAD file, 2026-04-20]
CommunityContributions/Memphis/V2/3MF/OpenTricklerOrignalParts/SmallRotaryTube_LowFlowTube.3mf
15.0 x 54.0 x 15.0 mm
