Memphis003/OpenTrickler/CommunityContributions/Memphis/V2/3MF/FrontBody/FrontBodyWhitoutServoWithAcrylic.3mf

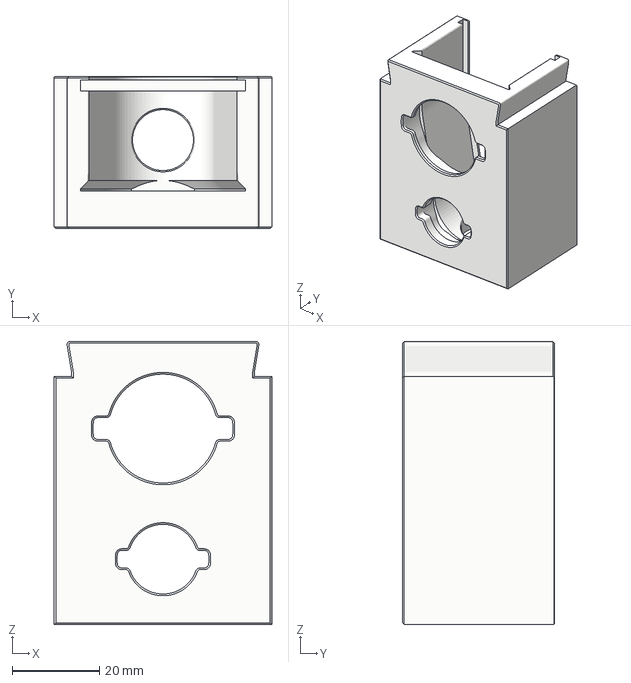
[picture p64: CAD file, 2026-03-31]
CommunityContributions/Memphis/V2/3MF/FrontBody/FrontBodyWhitoutServoWithAcrylic.3mf
50.0 x 35.0 x 65.0 mm
