Memphis003/OpenTrickler/CommunityContributions/Memphis/V2/3MF/Lid/Funnel33mm.3mf

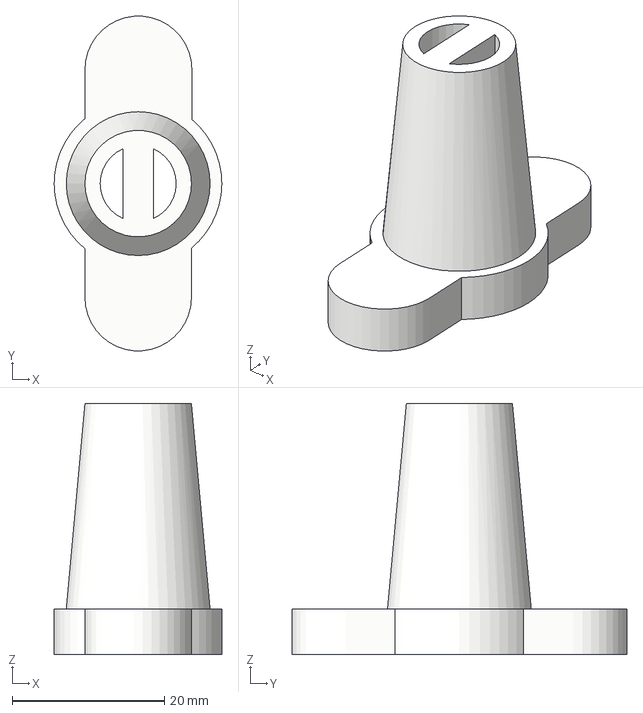
[picture p65: CAD file, 2026-04-20]
CommunityContributions/Memphis/V2/3MF/Lid/Funnel33mm.3mf
22.0 x 44.0 x 33.0 mm
