Memphis003/OpenTrickler/CommunityContributions/Memphis/V2/3MF/OpenTricklerOrignalParts/LargeRotaryTube.3mf

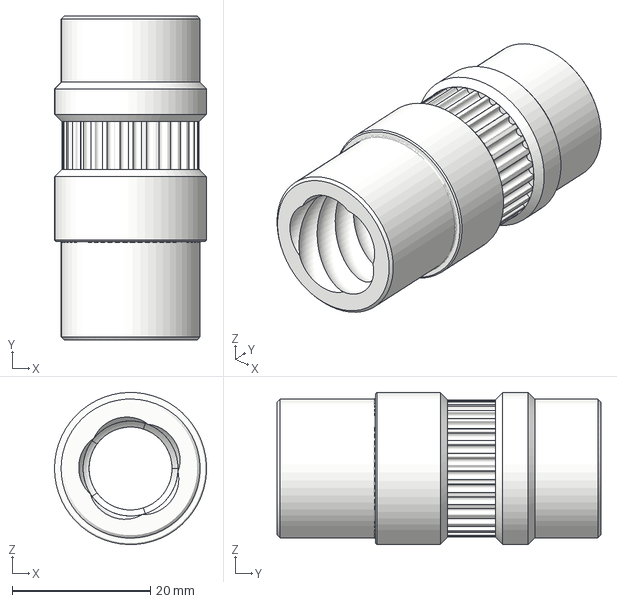
[picture p66: CAD file, 2026-04-20]
CommunityContributions/Memphis/V2/3MF/OpenTricklerOrignalParts/LargeRotaryTube.3mf
22.0 x 46.8 x 22.0 mm
