Memphis003/OpenTrickler/CommunityContributions/Memphis/V2/3MF/Lid/PowderBin.3mf

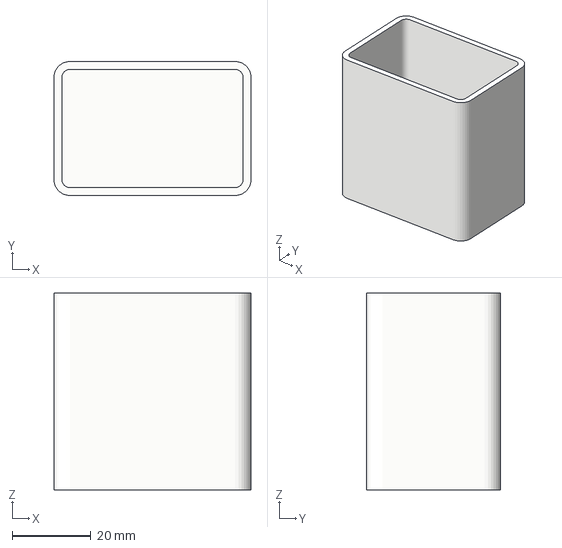
[picture p67: CAD file, 2026-03-31]
CommunityContributions/Memphis/V2/3MF/Lid/PowderBin.3mf
50.0 x 34.0 x 50.0 mm
