Memphis003/OpenTrickler/CommunityContributions/Memphis/V2/3MF/Lid/PowderBinBracket.3mf

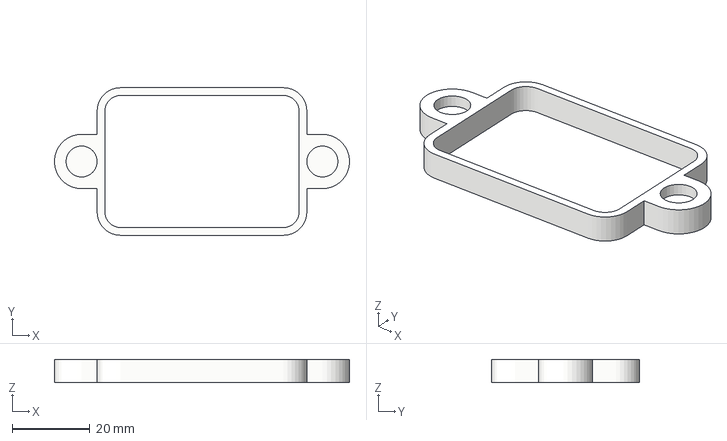
[picture p68: CAD file, 2026-03-31]
CommunityContributions/Memphis/V2/3MF/Lid/PowderBinBracket.3mf
76.0 x 38.0 x 6.00 mm
