Memphis003/OpenTrickler/(list of files, cad)

Other CAD files:
CommunityContributions/Memphis/V2/3MF/Display/FlyScreen_RightButton_Front.3mf
CommunityContributions/Memphis/V2/3MF/Lid/Lid_NoServos.3mf
CommunityContributions/Memphis/V2/3MF/OpenTricklerOrignalParts/RearVolumeReducerBack.3mf
CommunityContributions/Memphis/V2/3MF/Display/FlyScreen_RightButton_Back.3mf
CommunityContributions/Memphis/V1/CAD/A&D_FX_shield_Memphis.step
CommunityContributions/Memphis/V1/STL/cup_base.stl
CommunityContributions/Memphis/V1/STL/display_assy_body.stl
CommunityContributions/Memphis/V1/STL/display_assy_bracket.stl
CommunityContributions/Memphis/V1/STL/display_assy_button.stl
CommunityContributions/Memphis/V1/STL/display_assy_front.stl
CommunityContributions/Memphis/V1/STL/enclosure_bottom.stl
CommunityContributions/Memphis/V1/STL/enclosure_top.stl
CommunityContributions/Memphis/V1/STL/hopper_base_plexi.stl
CommunityContributions/Memphis/V1/STL/hopper_cap.stl
CommunityContributions/Memphis/V1/STL/powder_cup_handle.stl
CommunityContributions/Memphis/V1/STL/rear_body_without_holes.stl
CommunityContributions/Memphis/V1/STL/rear_discharge_cup_ring.stl
CommunityContributions/Memphis/V1/STL/rear_discharge_mount.stl
CommunityContributions/Memphis/V1/STL/rear_discharger_cup.stl
CommunityContributions/Memphis/V1/STL/rear_discharger_slinding_door.stl
CommunityContributions/Memphis/V1/STL/scale_base.stl
CommunityContributions/Memphis/V1/STL/scale_shield.stl
