Memphis003/OpenTrickler/(commit log)

2026-03-31 Update with V2
    [A&D_FX_shield_Memphis.step, Cap.3mf, CapWithHole.3mf, CupStop.3mf, DisplayBack.3mf, DisplayBracket.3mf, DisplayButton.3mf, DisplayFront.3mf]
2026-04-20 Update files
    Update files
    [BigCableBlock.3mf, BigTreetechScreen_Back.3mf, BigTreetechScreen_Front.3mf, Cap.3mf, CapWithHole.3mf, DisplayBack.3mf, DisplayBracket.3mf, DisplayButton.3mf]
